adiind/dpi-layered-music-maker/archive/README.md

# Archive

This directory holds project material that is useful for reference but is not part of the active DPI final demo.

## Contents

- `legacy-shape-fork/` - the earlier shape/color generated-music experiment. It explored tangible shape controls and a composed Tone.js engine before the project moved to the real five-channel DPI Music stem workflow.

## Active Project

Use [`../current/`](../current/) for the final demo app, audio stems, ESP32 firmware, and hardware wiring docs.

Archived code is intentionally not included in the primary run/build instructions.
