adiind/dpi-layered-music-maker/current/dpi-nfc-studio-mobile.png

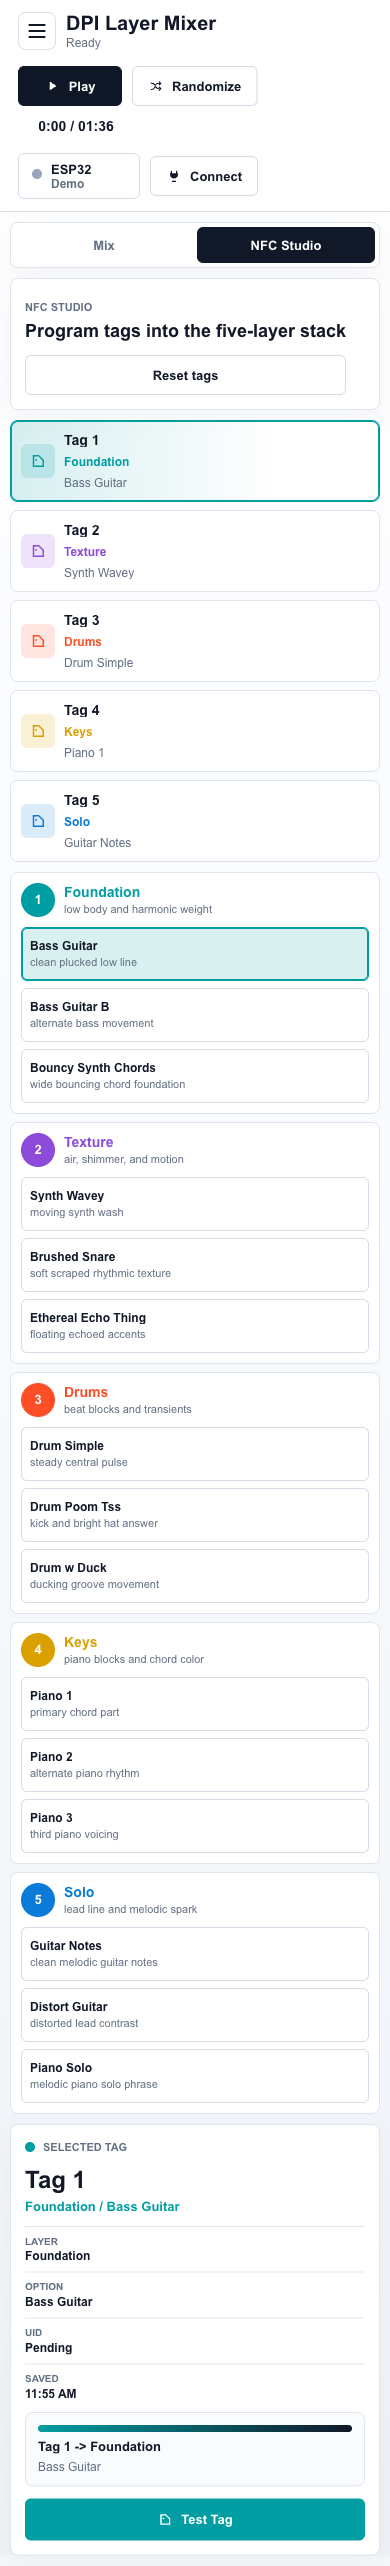
current/dpi-nfc-studio-mobile.png
