adiind/dpi-layered-music-maker/(commit log)

2026-06-02 Update NFC studio and ESP32 controller
2026-06-02 Fix NTAG write verification
    [DPI_2.ino]
2026-06-03 Use encoders for volume and mute
2026-06-03 Stabilize NFC presence polling
    [DPI_2.ino]
2026-06-03 Reject cards in wrong reader slots
    [DPI_2.ino]
2026-06-03 Guard encoder diagnostic fallback
2026-06-03 Make encoder fallback deterministic
2026-06-03 Use interrupts for encoder turns
2026-06-03 Reverse NeoPixel layer order
    [DPI_2.ino]
2026-06-03 Stabilize NFC presence and LED diagnostics
    [DPI_2.ino]
2026-06-03 Visualize encoder button toggles
2026-06-03 Tune encoder direction and NFC recognition
